DaBiggestSeal/BOARD-mic/mic.kicad_pcb

## KiCad design mic.kicad_pcb (2026-10-27)

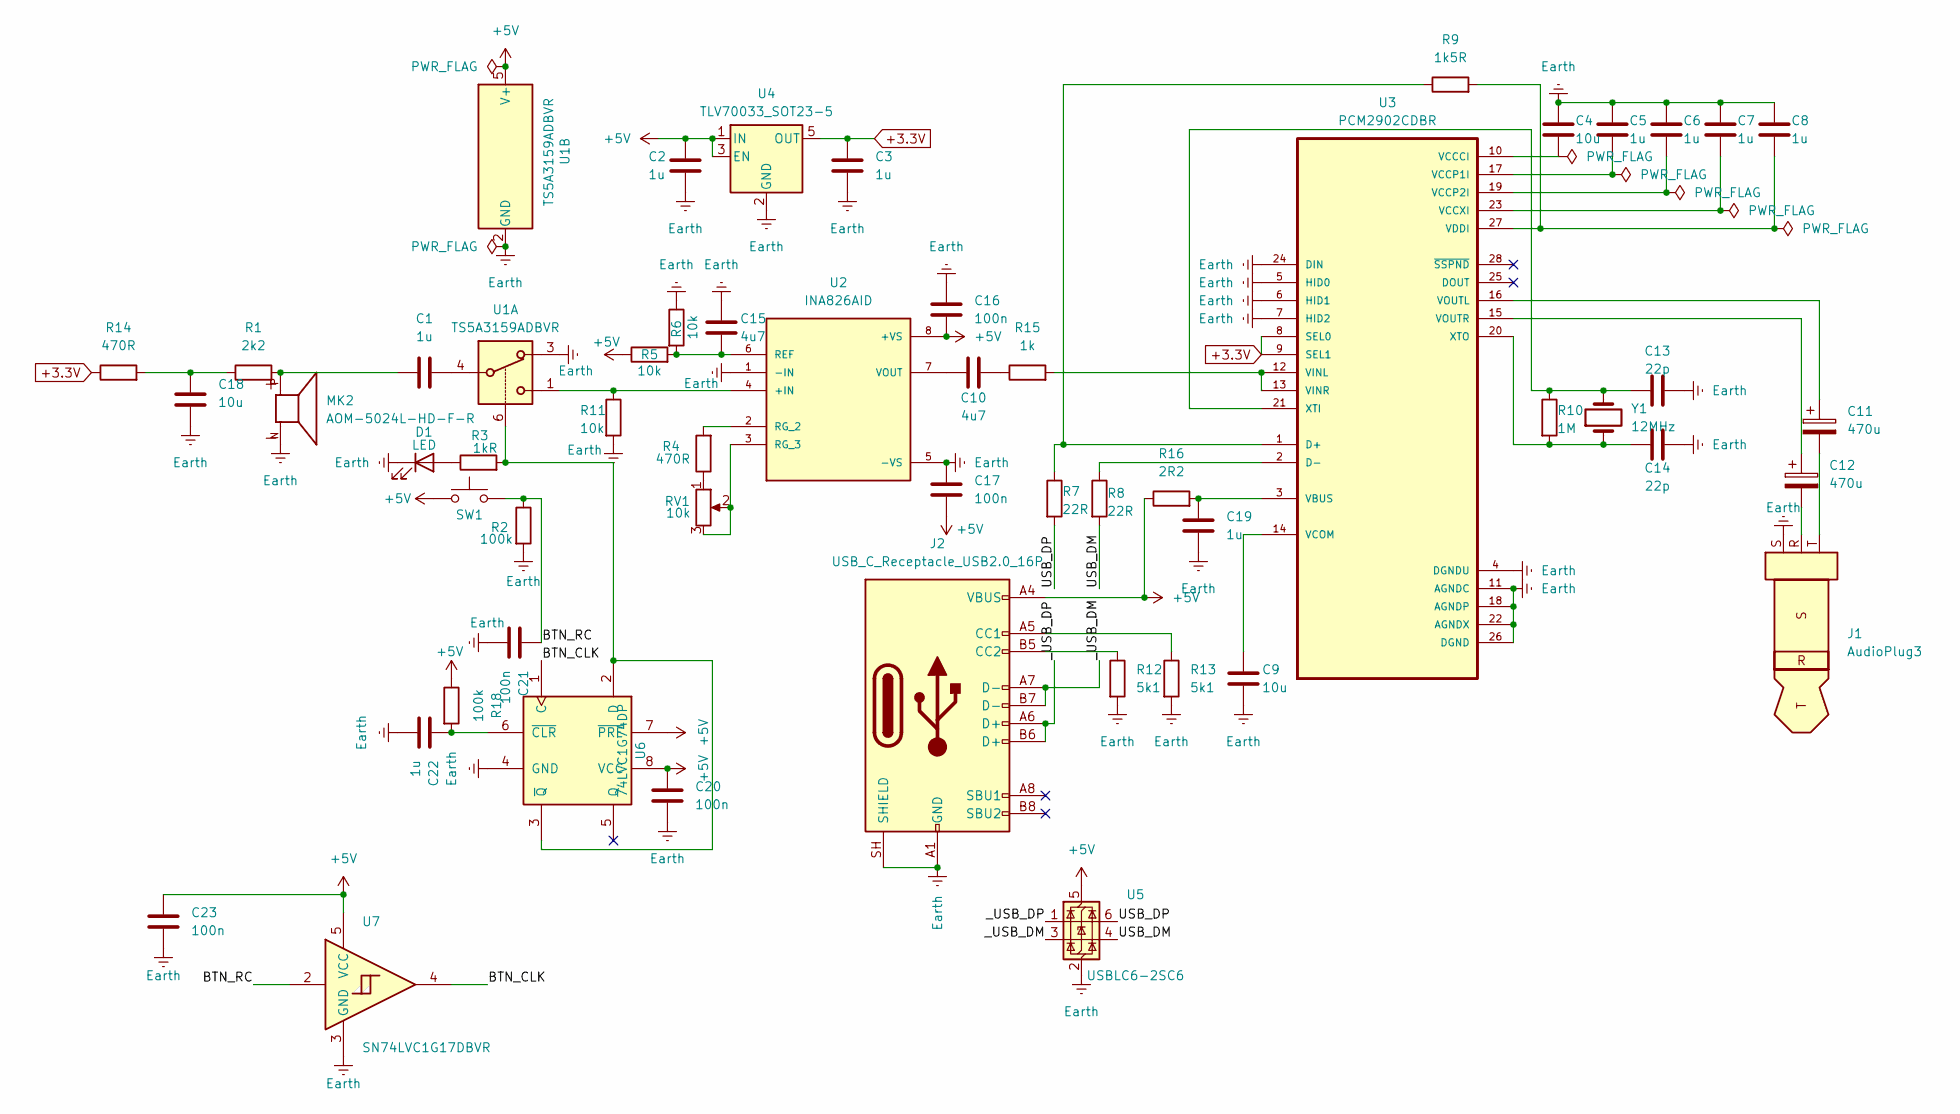
[picture p1: schematic mic.kicad_sch]

Parts:
C1, C2, C3, C5, C6, C7, C8, C19, C22: 1u; C_0603_1608Metric; LCSC C15849
C4, C9, C18: 10u; C_0603_1608Metric; LCSC C19702
C10, C15: 4u7; C_0603_1608Metric; LCSC C19666
C11, C12: 470u; CP_Elec_8x10; LCSC C2858857
C13, C14: 22p; C_0603_1608Metric; LCSC C1653
C16, C17, C20, C21, C23: 100n; C_0603_1608Metric; LCSC C149620
D1: LED; LED_D1.8mm_W1.8mm_H2.4mm_Horizontal_O1.27mm_Z1.6mm; LCSC C2917798
J1: AudioPlug3; Jack_3.5mm_KoreanHropartsElec_PJ-3920-3A_Vertical; LCSC C707259
J2: USB_C_Receptacle_USB2.0_16P; USB_C_Receptacle_G-Switch_GT-USB-7051x_NoA8; LCSC C2843970
MK2: AOM-5024L-HD-F-R; MIC_AOM-5024L-HD-F-R; PARTREV A; LCSC C3273730
R1: 2k2; R_0603_1608Metric; LCSC C4190
R2, R18: 100k; R_0603_1608Metric; LCSC C25803
R3: 1kR; R_0603_1608Metric; LCSC C22548
R4, R14: 470R; R_0603_1608Metric; LCSC C23179
R5, R6, R11: 10k; R_0603_1608Metric; LCSC C98220
R7, R8: 22R; R_0603_1608Metric; LCSC C23345
R9: 1k5R; R_0603_1608Metric; LCSC C22843
R10: 1M; R_0603_1608Metric; LCSC C22935
R12, R13: 5k1; R_0603_1608Metric; LCSC C23186
R15: 1k; R_0603_1608Metric; LCSC C22548
R16: 2R2; R_0603_1608Metric; LCSC C112307
RV1: 10k; Potentiometer_Alps_RK097_Single_Horizontal; LCSC C470577
SW1: SW_Push; SW_Tactile_SPST_Angled_PTS645Vx58-2LFS; LCSC alr C51018255
U1: TS5A3159ADBVR; SOT-23-6; LCSC C128405
U2: INA826AID; SOIC127P599X175-8N; PARTREV G; DigiKey_Part_Number 296-33294-5-ND
U3: PCM2902CDBR; SOP65P780X200-28N; DigiKey_Part_Number 2156-PCM2902CDBR-ND
U4: TLV70033_SOT23-5; SOT-23-5; LCSC C11337
U5: USBLC6-2SC6; SOT-23-6; LCSC C7519
U6: 74LVC1G74DP; TSSOP-8_3x3mm_P0.65mm; LCSC C548409
U7: SN74LVC1G17DBVR; SOT-23-5; LCSC C7836
Y1: 12MHz; Crystal_SMD_5032-2Pin_5.0x3.2mm; LCSC C112573

Connections:
+3.3V: C3.1, R14.1, U3.8 (SEL0), U3.9 (SEL1), U4.5 (OUT)
+5V: C2.2, C16.2, C17.2, C20.1, C23.1, J2.A4 (VBUS), J2.A9 (VBUS), J2.B4 (VBUS), J2.B9 (VBUS), R5.1, R16.1, R18.1, SW1.1, U1.5 (V+), U2.8 (+VS), U4.1 (IN), U4.3 (EN), U5.5 (VBUS), U6.7 (~PRE), U6.8 (VCC), U7.5 (VCC)
/BTN_CLK: U6.1 (C), U7.4
/BTN_RC: C21.1, R2.1, SW1.2, U7.2
/USB_DM: R8.2, U5.4 (I/O2)
/USB_DP: R7.2, U5.6 (I/O1)
/_USB_DM: J2.A7 (D-), J2.B7 (D-), U5.3 (I/O2)
/_USB_DP: J2.A6 (D+), J2.B6 (D+), U5.1 (I/O1)
Earth: C2.1, C3.2, C4.1, C5.1, C6.1, C7.1, C8.1, C9.2, C13.2, C14.2, C15.1, C16.1, C17.1, C18.2, C19.2, C20.2, C21.2, C22.2, C23.2, D1.1 (K), J1.S, J2.A1 (GND), J2.A12 (GND), J2.B1 (GND), J2.B12 (GND), J2.SH (SHIELD), MK2.N, R2.2, R6.1, R11.2, R12.2, R13.2, U1.2 (GND), U1.3, U2.1 (-IN), U2.5 (-VS), U3.4 (DGNDU), U3.5 (HID0), U3.6 (HID1), U3.7 (HID2), U3.11 (AGNDC), U3.18 (AGNDP), U3.22 (AGNDX), U3.24 (DIN), U3.26 (DGND), U4.2 (GND), U5.2 (GND), U6.4 (GND), U7.3 (GND)
unnamed: C1.1, MK2.P, R1.2
unnamed: C1.2, U1.4
unnamed: C10.1, R15.1
unnamed: C11.2, J1.T
unnamed: C12.2, J1.R
unnamed: C18.1, R1.1, R14.2
unnamed: D1.2 (A), R3.1
unnamed: J2.A5 (CC1), R13.1
unnamed: J2.B5 (CC2), R12.1
unnamed: R4.1, RV1.1
unnamed: R11.1, U1.1, U2.4 (+IN)
unnamed: C15.2, R5.2, R6.2, U2.6 (REF)
unnamed: R4.2, U2.2 (RG_2)
unnamed: RV1.2, RV1.3, U2.3 (RG_3)
unnamed: C10.2, U2.7 (VOUT)
unnamed: R7.1, R9.1, U3.1 (D+)
unnamed: R8.1, U3.2 (D-)
unnamed: C19.1, R16.2, U3.3 (VBUS)
unnamed: C4.2, U3.10 (VCCCI)
unnamed: C5.2, U3.17 (VCCP1I)
unnamed: C6.2, U3.19 (VCCP2I)
unnamed: C7.2, U3.23 (VCCXI)
unnamed: C9.1, U3.14 (VCOM)
unnamed: C8.2, R9.2, U3.27 (VDDI)
unnamed: R15.2, U3.12 (VINL), U3.13 (VINR)
unnamed: C11.1, U3.16 (VOUTL)
unnamed: C12.1, U3.15 (VOUTR)
unnamed: C13.1, R10.1, U3.21 (XTI), Y1.2
unnamed: C14.1, R10.2, U3.20 (XTO), Y1.1
unnamed: R3.2, U1.6, U6.2 (D), U6.3 (~Q)
unnamed: C22.1, R18.2, U6.6 (~CLR)

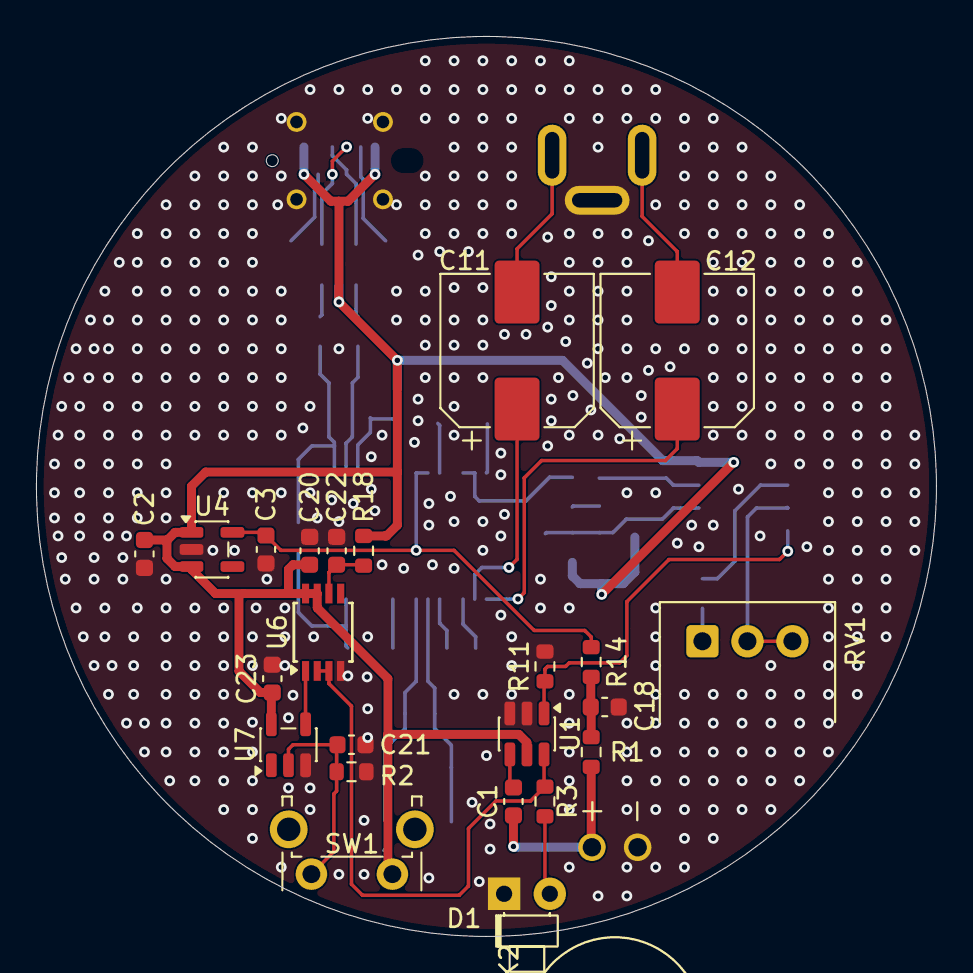
[picture p2: board mic.kicad_pcb from above]

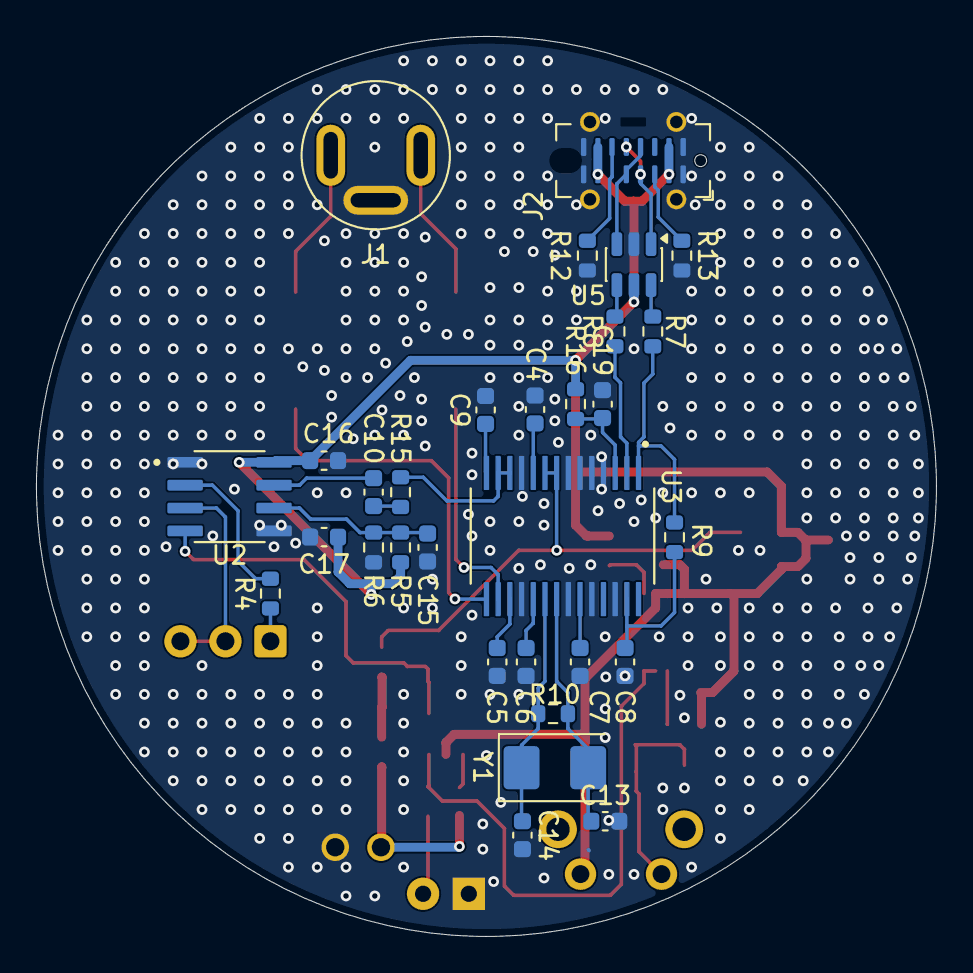
[picture p3: board mic.kicad_pcb from below]

Board: 2 copper layers, 50.0 x 50.0 mm, 54 parts (30 on the bottom side), 40 nets.
