DaBiggestSeal/BOARD-mic/(commit log)

2026-09-21 idk why it didnt work on my main pc so making this commit hopefully fixes that
    [mic.kicad_pcb]
2026-09-21 Added lcsc codes to parts
    [mic.kicad_sch]
2026-09-21 Holy board
    [mic.kicad_pcb]
2026-09-21 Even more holy board
    [mic.kicad_pcb]
2026-10-09 Add mic-bias/VBUS filters, codec input R, USB ESD; stereo jack
    - R14/C18 mic-bias RC filter, R15 codec input resistor
    - R16/C19 VBUS filter for PCM2902C, U5 USBLC6-2SC6 on D+/D-
    - J1 -> PJ-3920-3A stereo jack (custom footprint in mic.pretty)
    - All passives THT; C3 moved next to LDO; reroutes under U3
    - LCSC: J2 C2843970, U3 code removed; R3 1k
    - review.md updated
2026-10-09 Review: Y1 accepted (bent legs), capacitor part notes
2026-10-23 redoing the board
